LarsN05/InnovationsProjekt/ip-chassis-main/ip-motorshield/web-page.html

# IP Chassis Telemetry

Live telemetry and PID tuning over WiFi

Status: Disconnected

Connect

Start Moving Stop Moving

Connect to the ESP32 AP, then click Connect.

Encoder motor test

Target rpm: 0

Set Stop

Target: - rpm Measured: - rpm Ticks: -

PID and Settings

P I D Normal motor speed (0-4095)

advanced

Drive loop Hz Telemetry update Hz Enable deadzone compensation Min PWM to move Stop at checkpoints Brake when stopped Enable supply rails and M1/M2 current monitoring

Send Params Defaults

Live plot - Sensor error and Motor speeds (L / R)

No telemetry yet

Plot window (s) Save PNG

Sensor Error (left axis) Left Speed (right axis) Right Speed (right axis) Checkpoint

Telemetry (live)

QTR 0

QTR 1

QTR 2

QTR 3

QTR 4

Sensor Error

Left Speed

Right Speed

Battery V

P

I

D

Normal motor speed

Checkpoints

Last checkpoint ms

advanced telemetry

Servo rail V

M1 current A

M2 current A

Drive loop Hz (target)

Telemetry Hz (target)

Drive loop Hz (measured)

Drive loop exec us

Telemetry Hz (measured)

Telemetry exec us (peak)

Timestamp ms

Clear Console

Ready. Click Connect to start.
