LarsN05/InnovationsProjekt/ip-chassis-main/Hardware/Lasercut Files/A11_Motorshield-Stütze.pdf

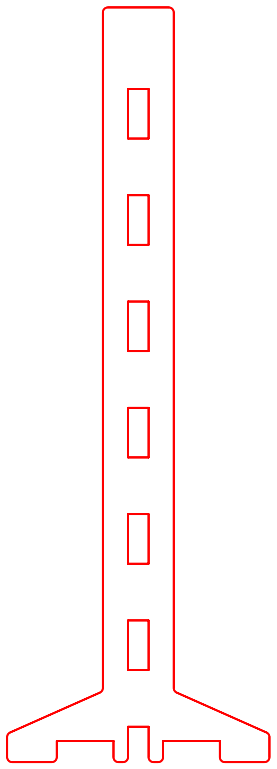
[picture p3: figure]
