LarsN05/InnovationsProjekt/ip-chassis-main/docs/BOM_MechatronikKit_IP26_20260826.pdf

### Innovationsprojekt 2026

# Mechatronik-Kit Inhalt

KOMPONENTEN

ESP32-S3 | https://www.waveshare.com/esp32-s3-dev-kit-n8r8.htm?sku=28836 Anzahl: 1 Hersteller: Waveshare Hersteller Art. Nr: ESP32-S3-DEV-KIT-N16R8-M

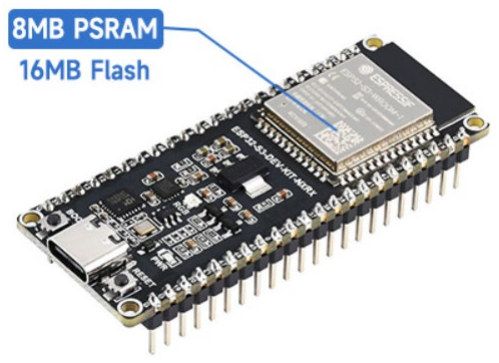
[picture p4: figure]

Motorshield ESP32-S3 - DRV8251A | Siehe GitLab-Repository • 6x DC-Motoren Steckplätze • 8x Servo Steckplätze • IOs + GND + 3.3V Header Anzahl: 1 Hersteller: Eigenbau ETH, pd|z

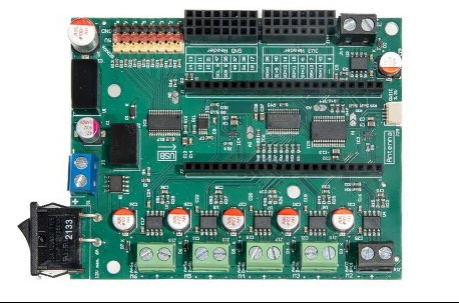
[picture p5: figure]

ESP32-S3 mit Motorshield gestacked

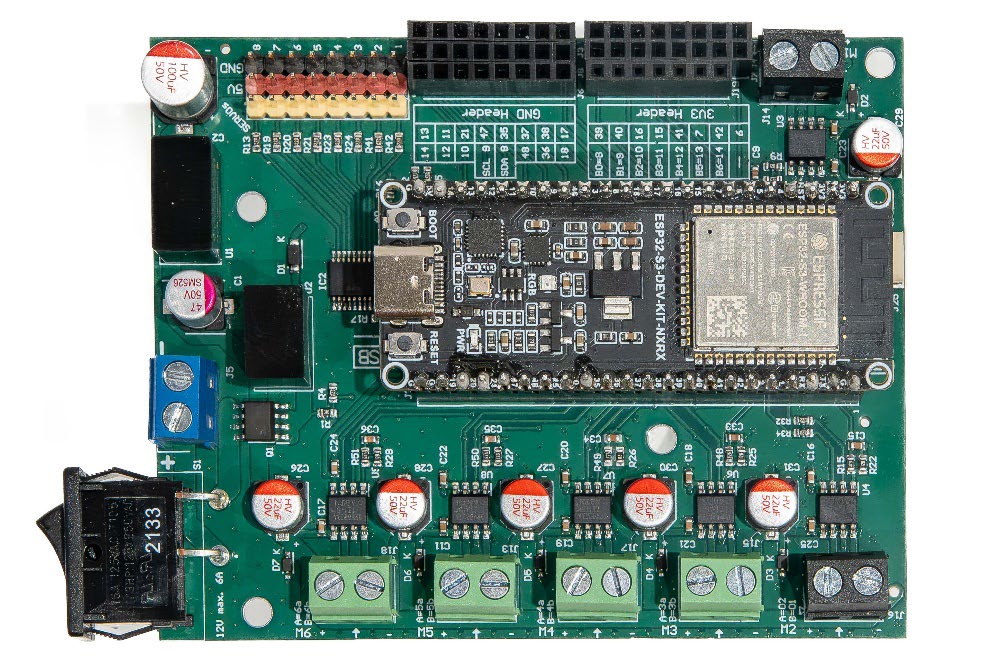
[picture p6: figure]

Jumper Kabel 20cm | https://www.mouser.ch/ProductDetail/Twin-Industries/TW-MF- 20C?qs=4qgZ1GHix0WzAEYYWLonEg%3D%3D (https://www.mouser.ch/ProductDetail/Twin-Industries/TW-MF-20C?qs=4qgZ1GHix0WzAEYYWLonEg%3D%3D)

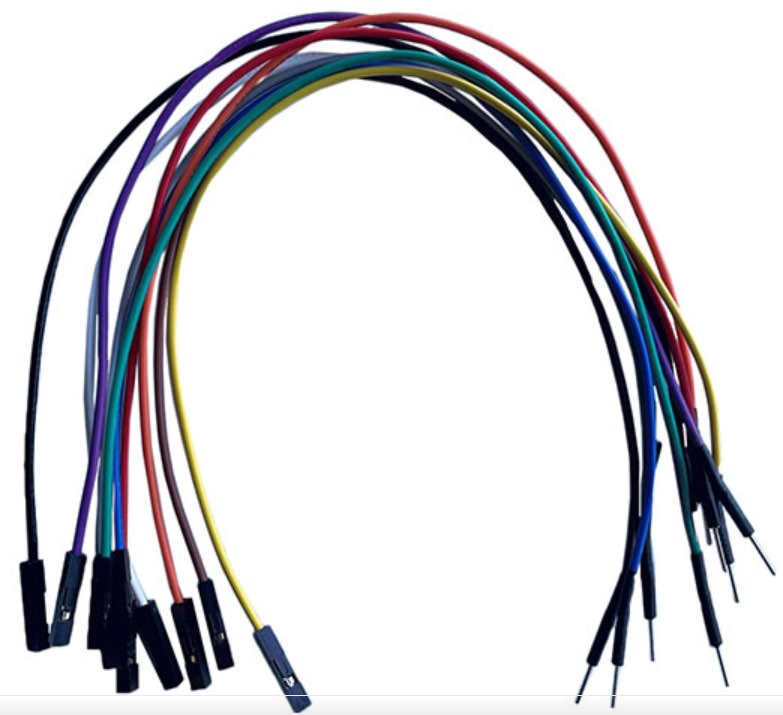
[picture p7: figure]

| Jumper-Kabel (Schaltdraht; Stecker - Buchse) 20cm, bunt
| Anzahl: 10 Käbelchen Hersteller: Twin Industries Hersteller Art. Nr: TW-MF-20C

Jumper Kabel 30cm | https://www.digikey.ch/en/products/detail/twin-industries/TW-MF-30C/14565017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 (https://www.digikey.ch/en/products/detail/twin-industries/TW-MF-30C/14565017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) Jumper-Kabel (Schaltdraht; Stecker - Buchse) 30cm, bunt Anzahl: 10 Käbelchen Hersteller: Twin Industries Hersteller Art. Nr: TW-MF-30C

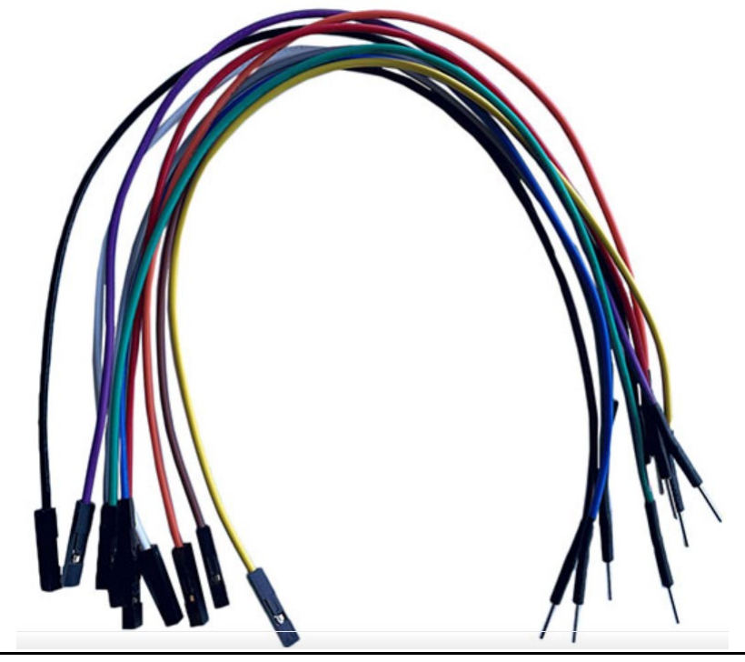
[picture p8: figure]

USB-C Kabel | https://www.conrad.ch/de/p/renkforce-usb-kabel-usb-c-stecker-usb-c-stecker-1-00-m-weiss-verdrillte-paare-rf-6056878-3028439.html (https://www.conrad.ch/de/p/renkforce-usb-kabel-usb-c-stecker-usb-c-stecker-1-00-m-weiss-verdrillte-paare-rf-6056878-3028439.html) Anzahl: 1 Hersteller: Renkforce Hersteller Art. Nr: RF-6056878

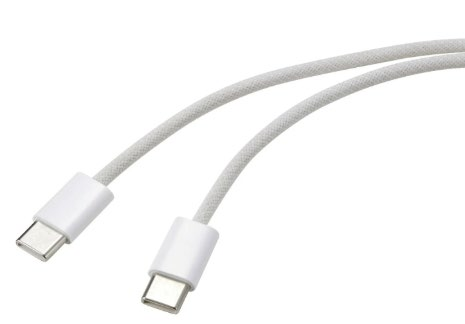
[picture p9: figure]

Servo S5252-030 | https://www.conrad.ch/de/p/reely-standard-servo-s-5252-030-digital-servo-getriebe-material-plastik-stecksystem-jr-2267525.html (https://www.conrad.ch/de/p/reely-standard-servo-s-5252-030-digital-servo-getriebe-material-plastik-stecksystem-jr-2267525.html) Anzahl: 2 Hersteller: Reely Typ: S5252-030 – 180 degrees

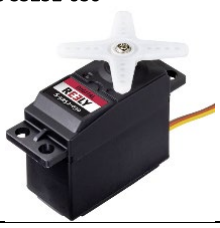
[picture p10: figure]

Servo TS90MD | https://de.aliexpress.com/item/1005009129632313.html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 v-specification (https://de.aliexpress.com/item/1005009129632313.html) Anzahl: 1 Hersteller: TIANKONGRC - AliExpress Typ: TS90MD - 270 degrees

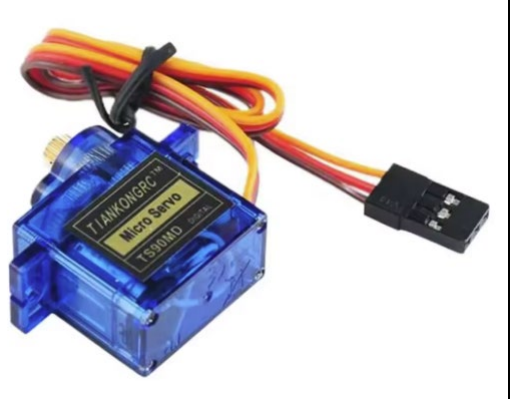
[picture p11: figure]
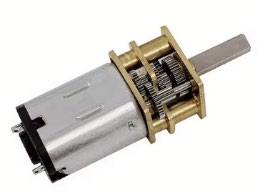
[picture p12: figure]

DC-Getriebemotor 60RPM | https://de.aliexpress.com/item/1005003431435613.html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 (https://de.aliexpress.com/item/1005003431435613.html?mp=1) Typ: 12V, 60RPM Hersteller: CNMAWAY Anzahl: 2

Doppelwellen Getriebemotor für Antrieb | https://de.aliexpress.com/item/1005006548341943.html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 (https://de.aliexpress.com/item/1005006548341943.html) Anzahl: 2 Hersteller: noname Typ: 3-12V
Reifen/Pneu für die Räder | https://www.brickowl.com/ch/catalog/lego-tire-37-x-22-zr-low-profile-55978 (https://www.brickowl.com/ch/catalog/lego-tire-37-x-22-zr-low-profile-55978) Anzahl: 2 Hersteller: Lego Hersteller Art. Nr. 55978 Typ: 37 x 22 zr low profile

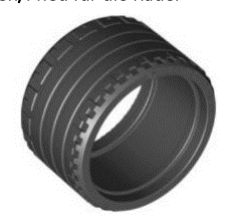
[picture p13: figure]

IR-Sensor | https://www.pololu.com/product/4145 Anzahl: 1 Hersteller: Pololu Typ: QTR-MD-05RC, 5-Channel Inkl. Befestigung (2x Kunststoffschraube M2, 25mm, 6x Sechskantmutter)

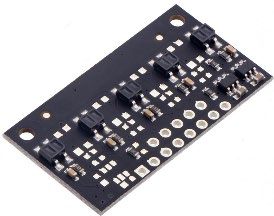
[picture p14: figure]

Drehrolle | https://www.pololu.com/product/953 Anzahl: 2 Hersteller: Pololu Hersteller Art. Nr.: 953

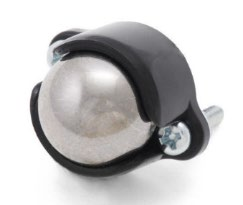
[picture p15: figure]

Akku | https://www.eremit.de/p/12v-2ah-flacher-lifepo4-mit-bms Anzahl: 1 Hersteller: EREMIT Typ: 12V 2Ah LiFePO4 mit JST-SM 2.54mm

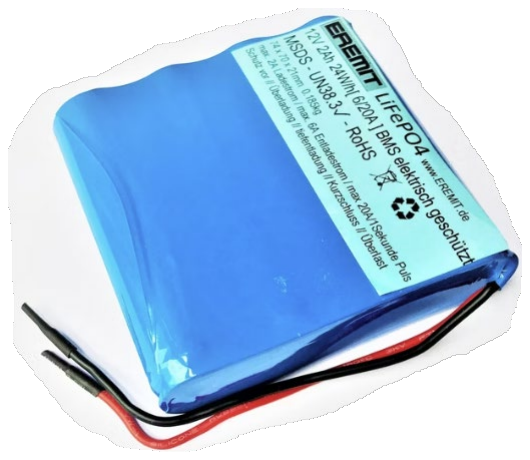
[picture p16: figure]

Ladegerät | https://www.eremit.de/p/12v-1a-lifepo4-ladegeraet Anzahl: 1 Hersteller: Eremit Typ: 12V 1A LiFePO4 Ladegerät mit JST-SM 2.54mm

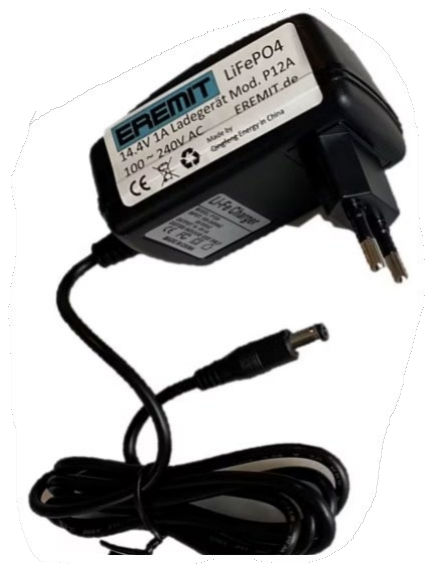
[picture p17: figure]

Kabelverbindung zwischen Motorshield & Akku | https://www.mouser.ch/ProductDetail/SparkFun/CAB-14574?qs=r5DSvlrkXmI%252B0h4Ae4w70g%3D%3D (https://www.mouser.ch/ProductDetail/SparkFun/CAB-14574?qs=r5DSvlrkXmI%252B0h4Ae4w70g%3D%3D) Anzahl: 1x Kabel mit Anschluss «male»

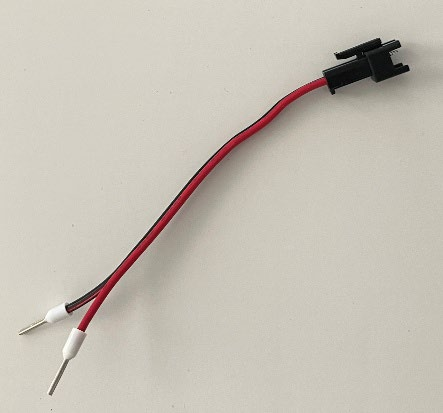
[picture p18: figure]
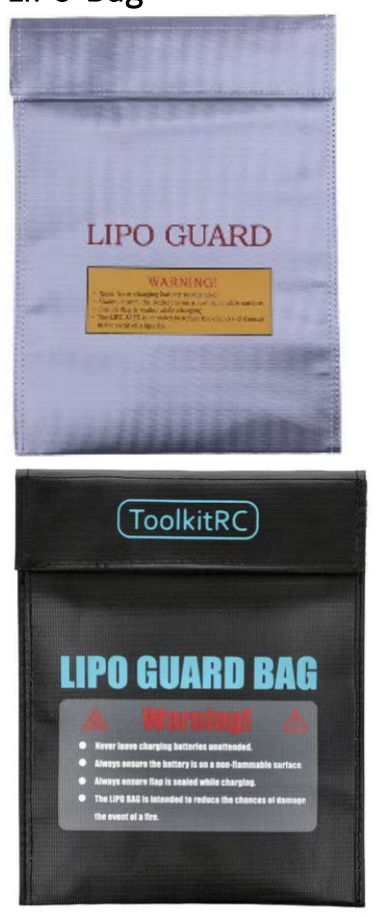
[picture p19: figure]

LiPo-Bag | https://www.brack.ch/g-t-power-lipo-tasche-large-981894https://www.brack.ch/toolkitrc-lipo-tasche-small-230-x-180-mm-1735426 (https://www.brack.ch/toolkitrc-lipo-tasche-small-230-x-180-mm-1735426) → Für Transport und Aufbewahrung Anzahl: 1 Hersteller: G.T. Power oder ToolkitRC Hersteller Art. Nr: 46 oder TK40600
