LarsN05/InnovationsProjekt/ip-chassis-main/docs/Stepfile_Motorshield_ESP32_V4_24082026.step

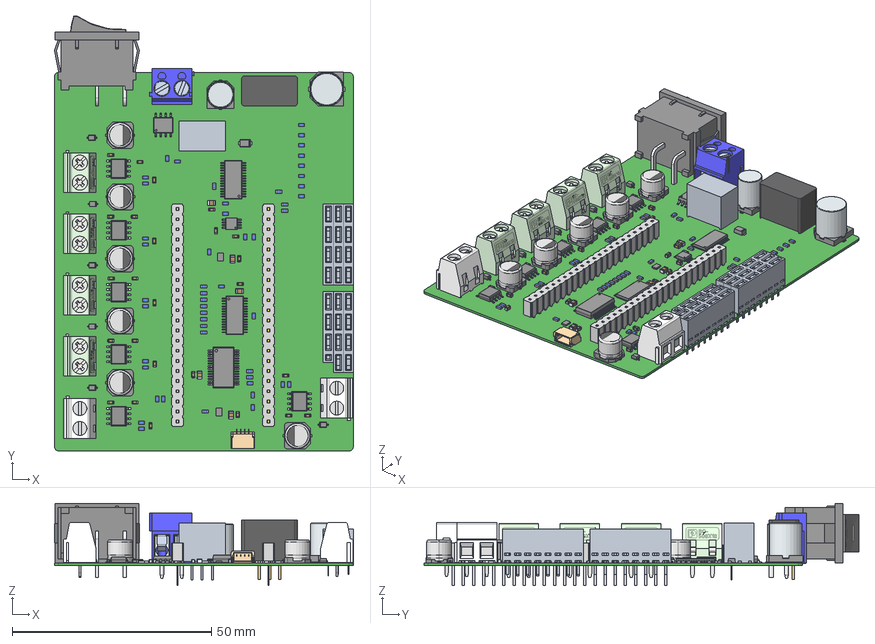
[picture p20: CAD file, 2026-09-24]
ip-chassis-main/docs/Stepfile_Motorshield_ESP32_V4_24082026.step
75.1 x 109.2 x 20.6 mm
FilletPinL x 6
FilletPinR x 6
PinsArrayLR x 5
KK_MKDSN_1_5_5_00 x 8
BC_508X10_SPP.1 x 8
AC_MKDSN_1_5_H1L x 8
BC_500X10_2_housing x 4
Insulator_2
Wire guard x 2
Screw x 2
Pin x 2
Pins x 2
PinKIdent
PinK
PinA
CES-122-01-S_socket x 2
012202SS x 2
012202SS2 x 2
BODY-SO x 6
LEAD-SO x 48
THERMALPAD-SO x 6
CASE-00
½¦-00
PIN-00 x 3
•W€SIZE CODE D-001_1 x 6
•W€SIZE CODE D-002_1 x 6
•W€SIZE CODE D-003_1 x 12
Base x 2
Pin1Fillet x 2
Pin2Fillet x 2
