LarsN05/InnovationsProjekt/ip-chassis-main/Hardware/STEP files/A11_Motorshield-Stütze.stp

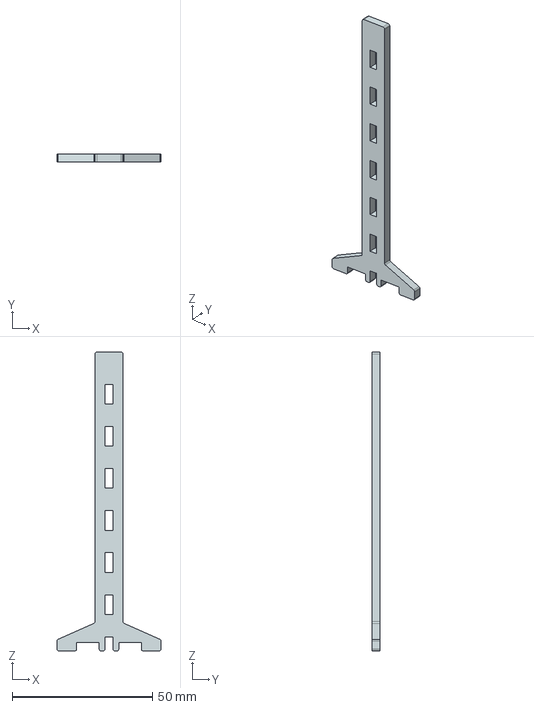
[picture p21: CAD file, 2026-09-24]
ip-chassis-main/Hardware/STEP files/A11_Motorshield-Stütze.stp
37.0 x 3.00 x 106.5 mm
