LarsN05/InnovationsProjekt/ip-chassis-main/Hardware/STEP files/A10_Sensor-Stütze.stp

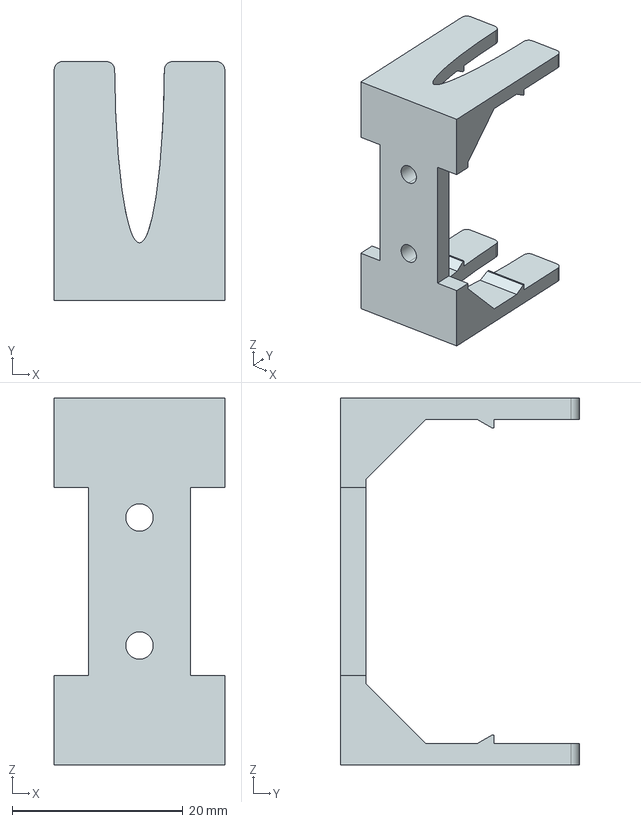
[picture p22: CAD file, 2026-09-24]
ip-chassis-main/Hardware/STEP files/A10_Sensor-Stütze.stp
20.0 x 28.0 x 43.0 mm
