LarsN05/InnovationsProjekt/ip-chassis-main/Hardware/STEP files/A04_Abstandshalter.stp

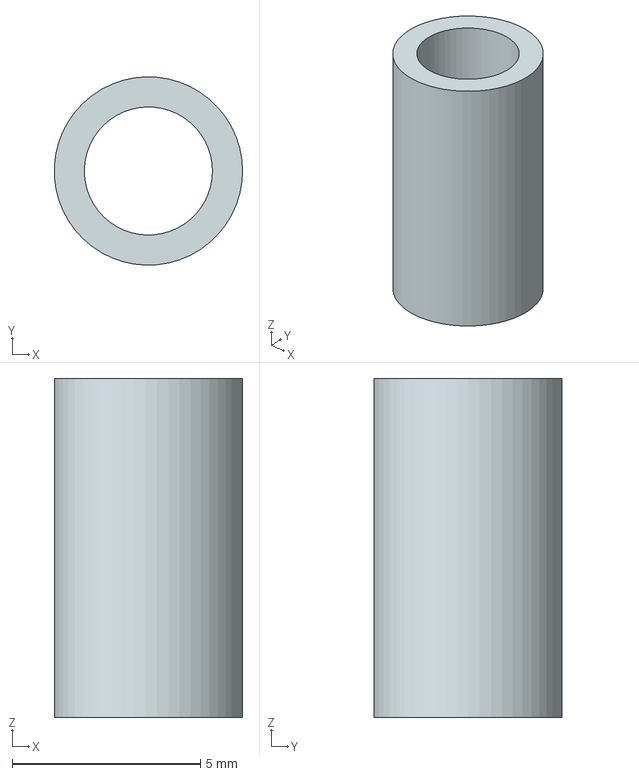
[picture p23: CAD file, 2026-09-24]
ip-chassis-main/Hardware/STEP files/A04_Abstandshalter.stp
5.00 x 5.00 x 9.00 mm
