LarsN05/InnovationsProjekt/ip-chassis-main/Hardware/STEP files/A12_Motorshield-Rahmen.stp

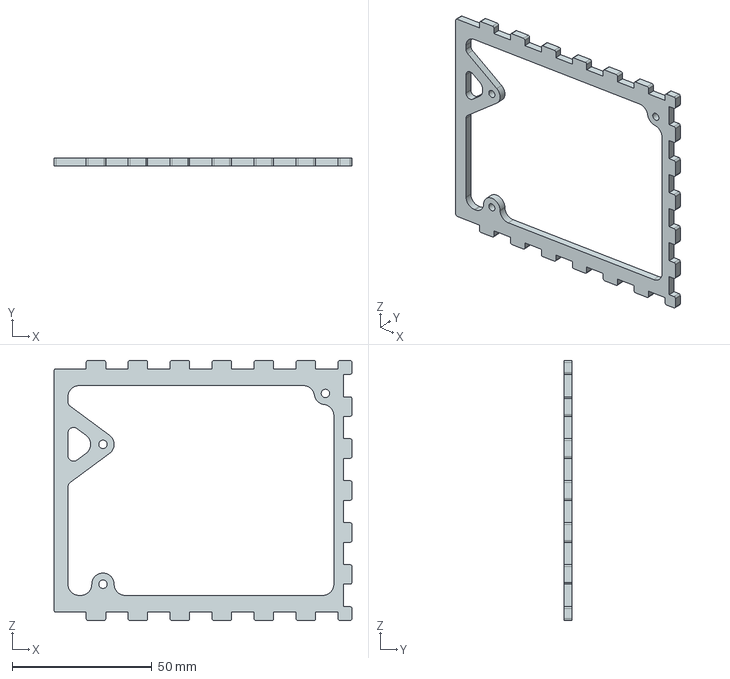
[picture p24: CAD file, 2026-09-24]
ip-chassis-main/Hardware/STEP files/A12_Motorshield-Rahmen.stp
106.5 x 3.00 x 93.0 mm
