LarsN05/InnovationsProjekt/ip-chassis-main/Hardware/STEP files/A06_Drehrollen-Halterung.stp

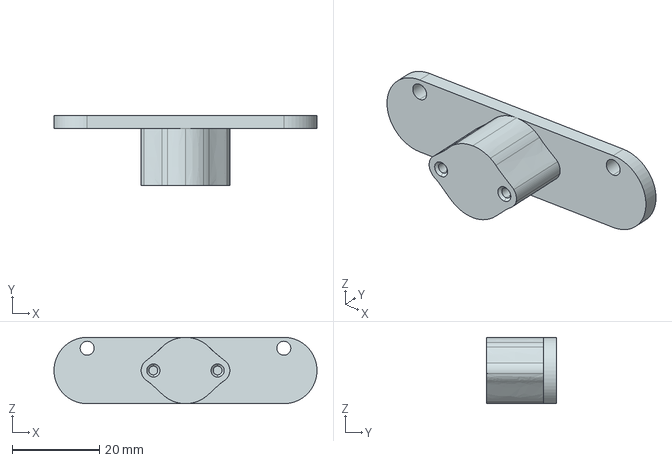
[picture p25: CAD file, 2026-09-24]
ip-chassis-main/Hardware/STEP files/A06_Drehrollen-Halterung.stp
60.2 x 16.0 x 15.2 mm
