LarsN05/InnovationsProjekt/ip-chassis-main/Hardware/STEP files/A05_Grundplatte.stp

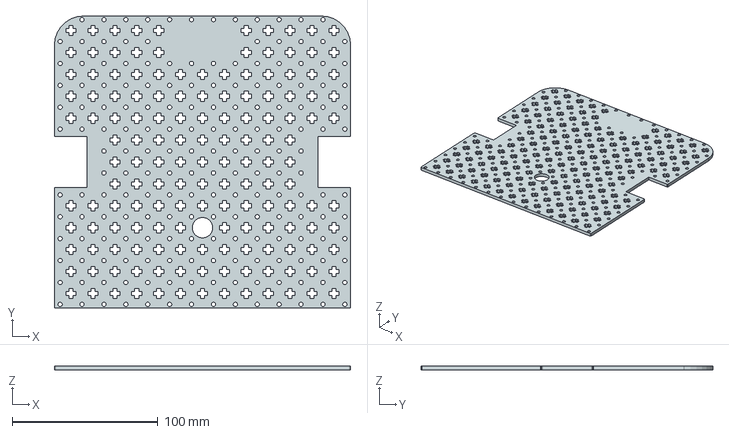
[picture p26: CAD file, 2026-09-24]
ip-chassis-main/Hardware/STEP files/A05_Grundplatte.stp
203.0 x 200.0 x 3.00 mm
