LarsN05/InnovationsProjekt/ip-chassis-main/Hardware/STEP files/A01_Batterie-Halterung.stp

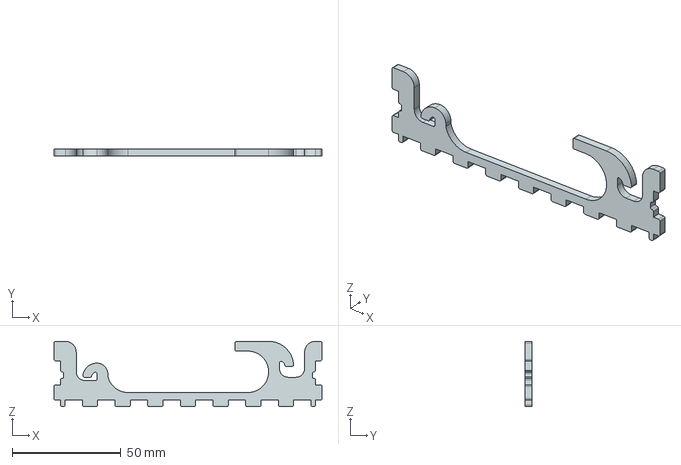
[picture p27: CAD file, 2026-09-24]
ip-chassis-main/Hardware/STEP files/A01_Batterie-Halterung.stp
123.0 x 3.00 x 30.0 mm
