LarsN05/InnovationsProjekt/ip-chassis-main/Hardware/STEP files/A09_Sensor-Rahmen.stp

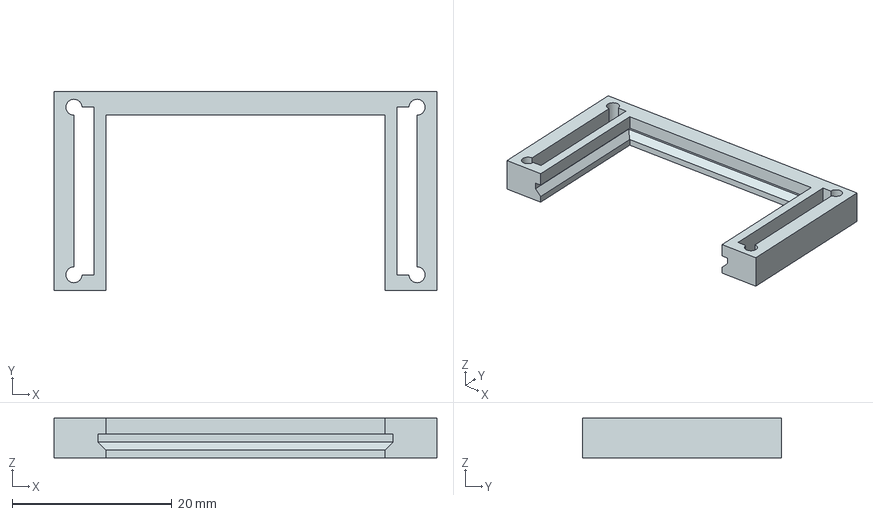
[picture p28: CAD file, 2026-09-24]
ip-chassis-main/Hardware/STEP files/A09_Sensor-Rahmen.stp
48.0 x 25.0 x 5.00 mm
