LarsN05/InnovationsProjekt/ip-chassis-main/docs/Schematic_Motorshield_ESP32_V4_25082026.PDF

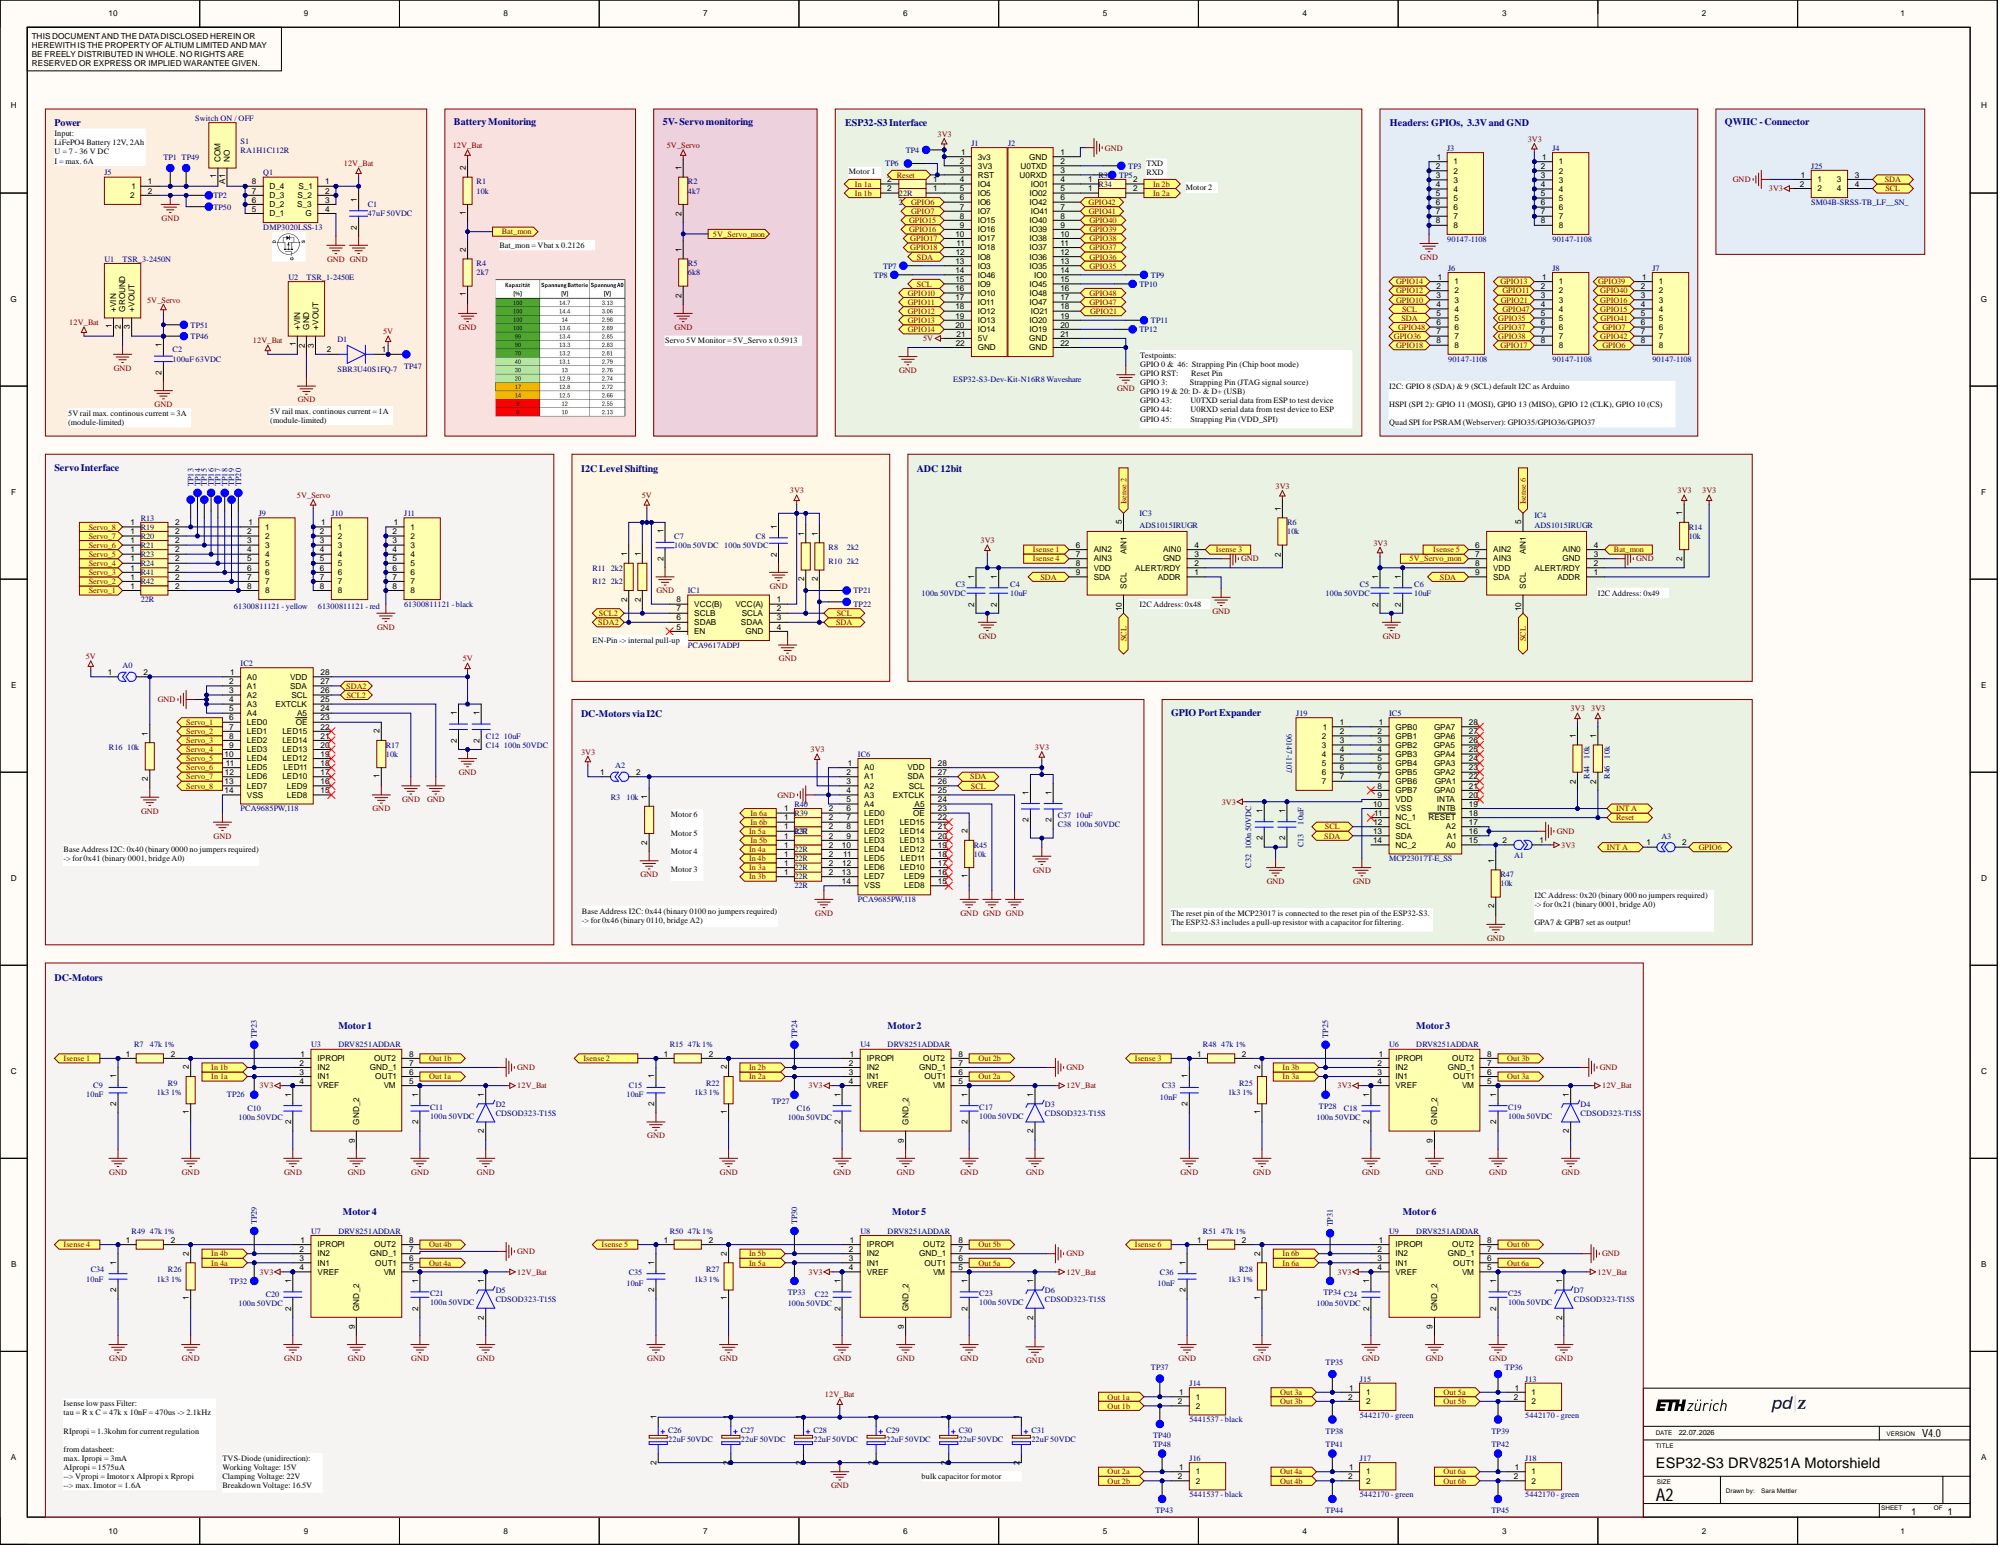
[picture p29: page 1]

THIS DOCUMENT AND THE DATA DISCLOSED HEREIN OR HEREWITH IS THE PROPERTY OF ALTIUM LIMITED AND MAY BE FREELY DISTRIBUTED IN WHOLE. NO RIGHTS ARE RESERVED OR EXPRESS OR IMPLIED WARANTEE GIVEN.

Headers: GPIOs, 3.3V and GND

Testpoints:
GPIO 0 & 46: Strapping Pin (Chip boot mode)
GPIO 19 & 20: D- & D+ (USB)

I2C: GPIO 8 (SDA) & 9 (SCL) default I2C as Arduino

5V rail max. continous current = 1A
(module-limited)

HSPI (SPI 2): GPIO 11 (MOSI), GPIO 13 (MISO), GPIO 12 (CLK), GPIO 10 (CS)

5V rail max. continous current = 3A

Quad SPI for PSRAM (Webserver): GPIO35/GPIO36/GPIO37

EN-Pin -> internal pull-up

Base Address I2C: 0x40 (binary 0000 no jumpersrequired)
-> for 0x41 (binary 0001, bridge A0)

I2C Address: 0x20 (binary 000 no jumpersrequired)
-> for 0x21 (binary 0001, bridge A0)

Base Address I2C: 0x44 (binary 0100 no jumpersrequired)
-> for 0x46 (binary 0110, bridge A2)

The reset pin of the MCP23017 is connected to the reset pin of the ESP32-S3.
The ESP32-S3 includes a pull-up resistor with a capacitor for filtering.

Isense low pass Filter:
tau = R x C = 47k x 10nF = 470us -> 2.1kHz

RIpropi = 1.3kohm for current regulation

from datasheet:
max. Ipropi = 3mA
AIpropi = 1575uA
--> Vpropi = Imotor x AIpropi x Rpropi
--> max. Imotor = 1.6A

bulk capacitor for motor

SIZE A2 | Drawn by: Sara Mettler

SHEET OF 1 1
