LarsN05/InnovationsProjekt/ip-chassis-main/Hardware/Technical Drawings/C02_Felgen_Technische-Zeichnung.pdf

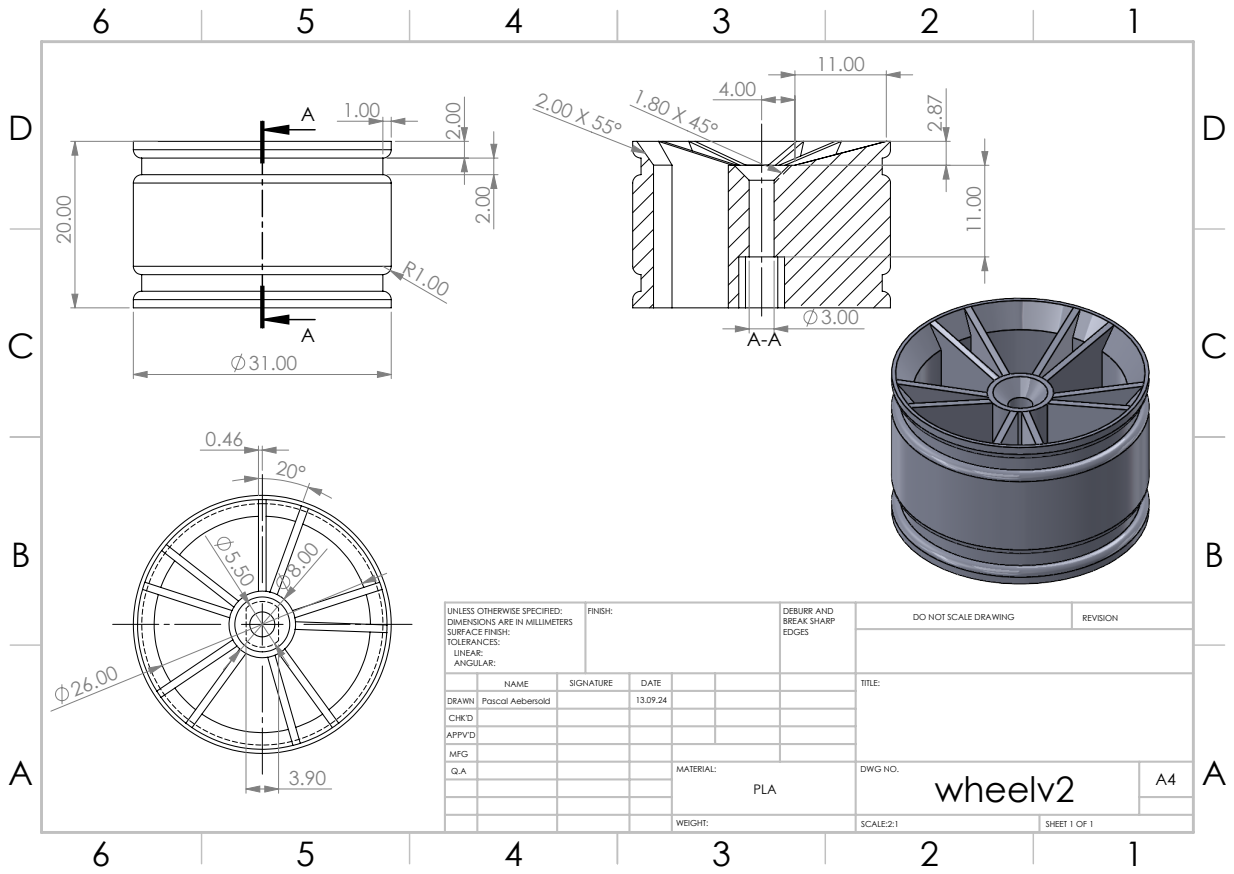
[picture p30: page 1]
FINISH:; DEBURR AND; BREAK SHARP; DO NOT SCALE DRAWING; REVISION; SCALE:2:1; SHEET 1 OF 1

UNLESS OTHERWISE SPECIFIED:
DIMENSIONS ARE IN MILLIMETERS
SURFACE FINISH:
TOLERANCES:
LINEAR:
ANGULAR:

NAME | SIGNATURE | DATE | | | | TITLE:

DRAWN | Pascal Aebersold | | 13.09.24
CHK'D
APPV'D
MFG
Q.A | | | | MATERIAL: PLA | DWG NO. wheelv2 | A4
