LarsN05/InnovationsProjekt/ip-chassis-main/docs/Assembly_BottomTop_Motorshield_ESP32_V4_25082026.PDF

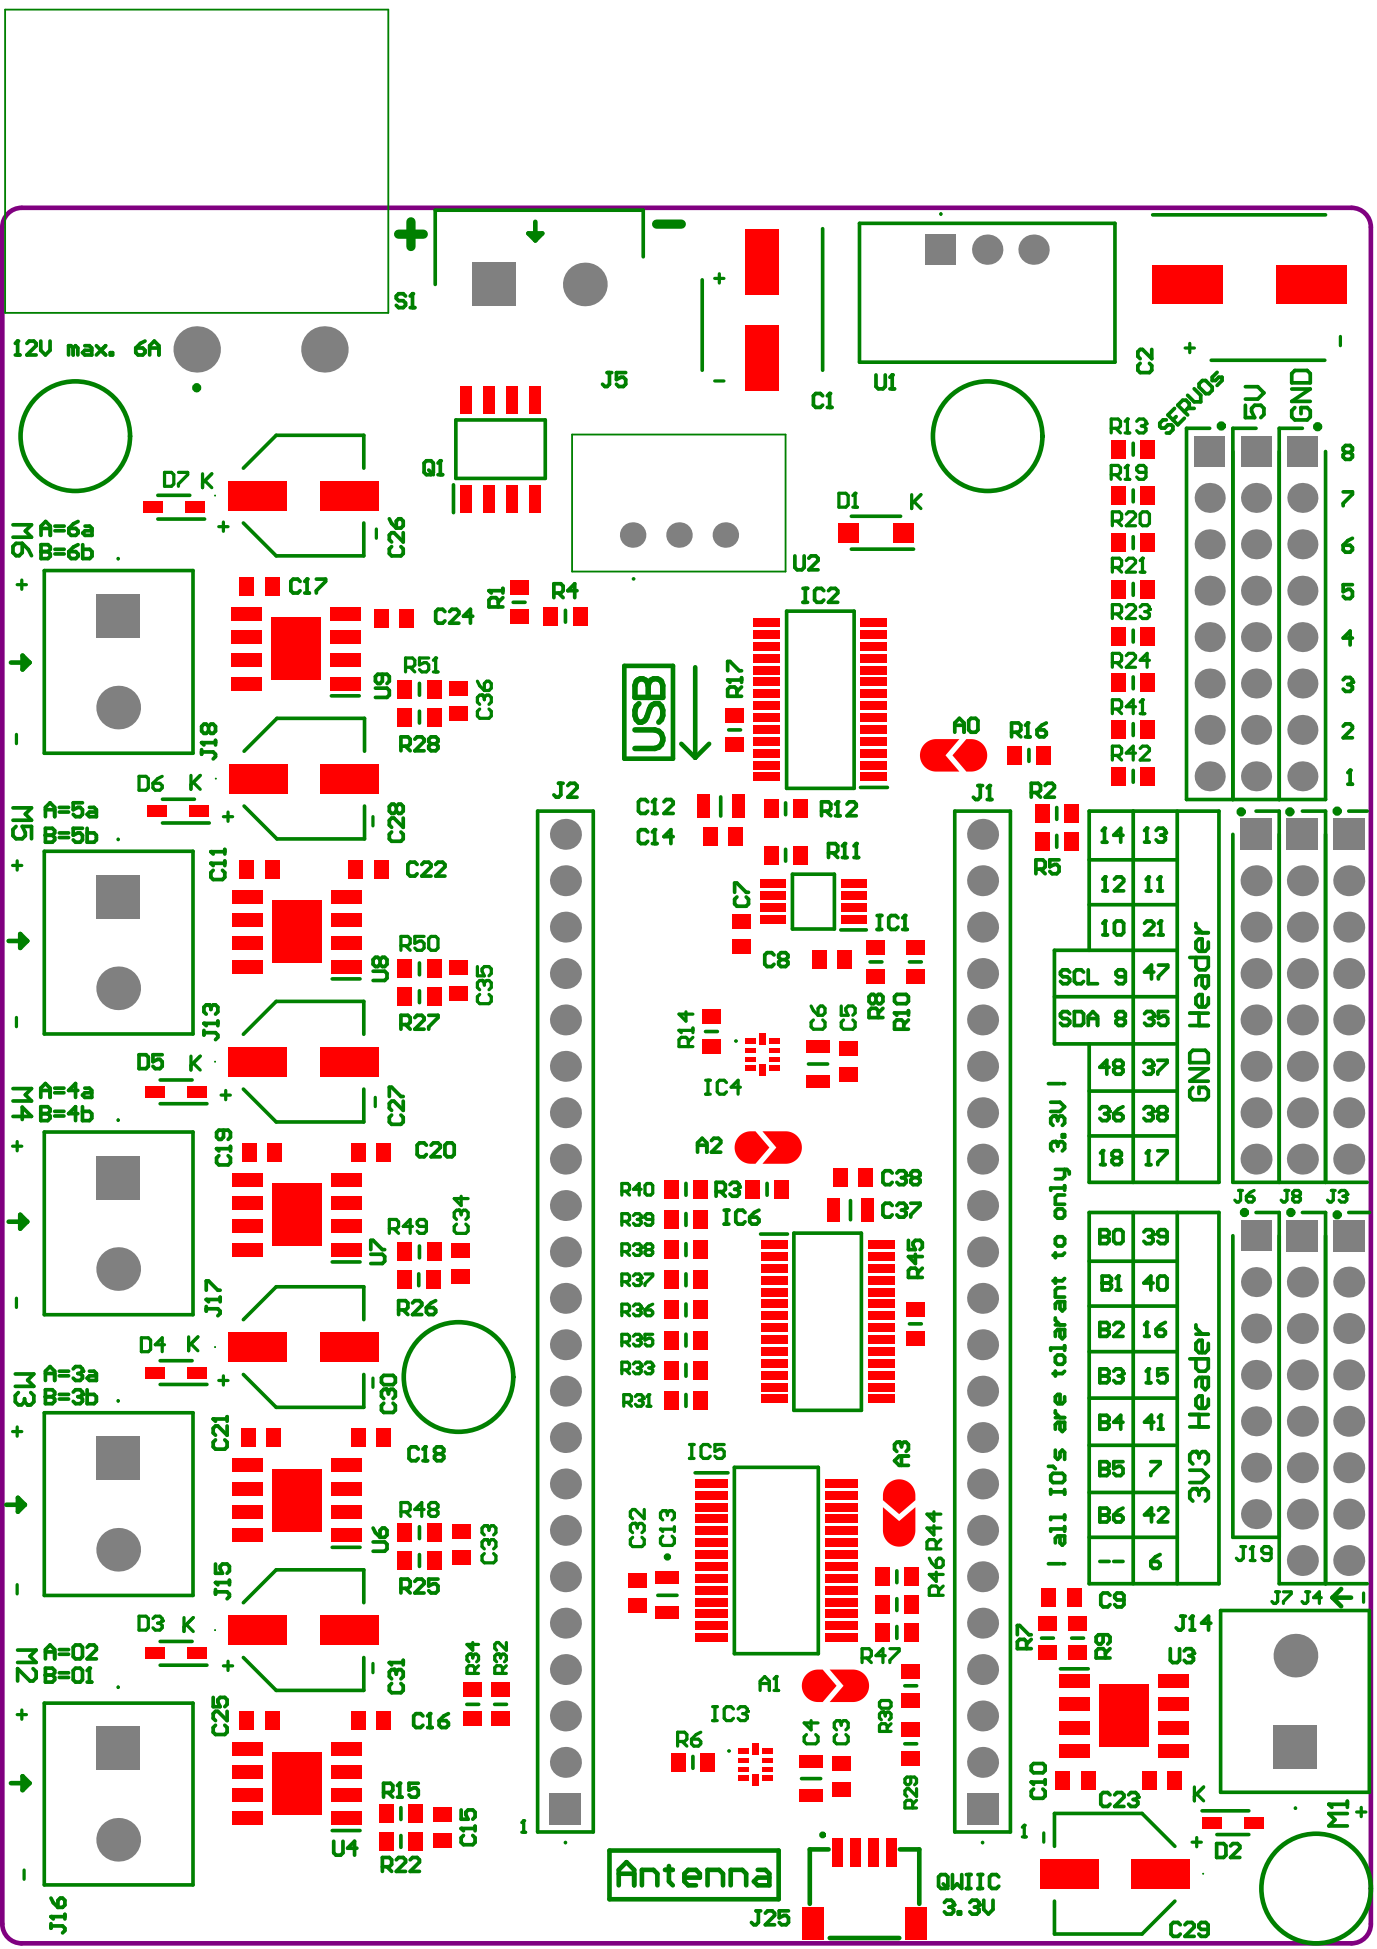
[picture p31: page 1]

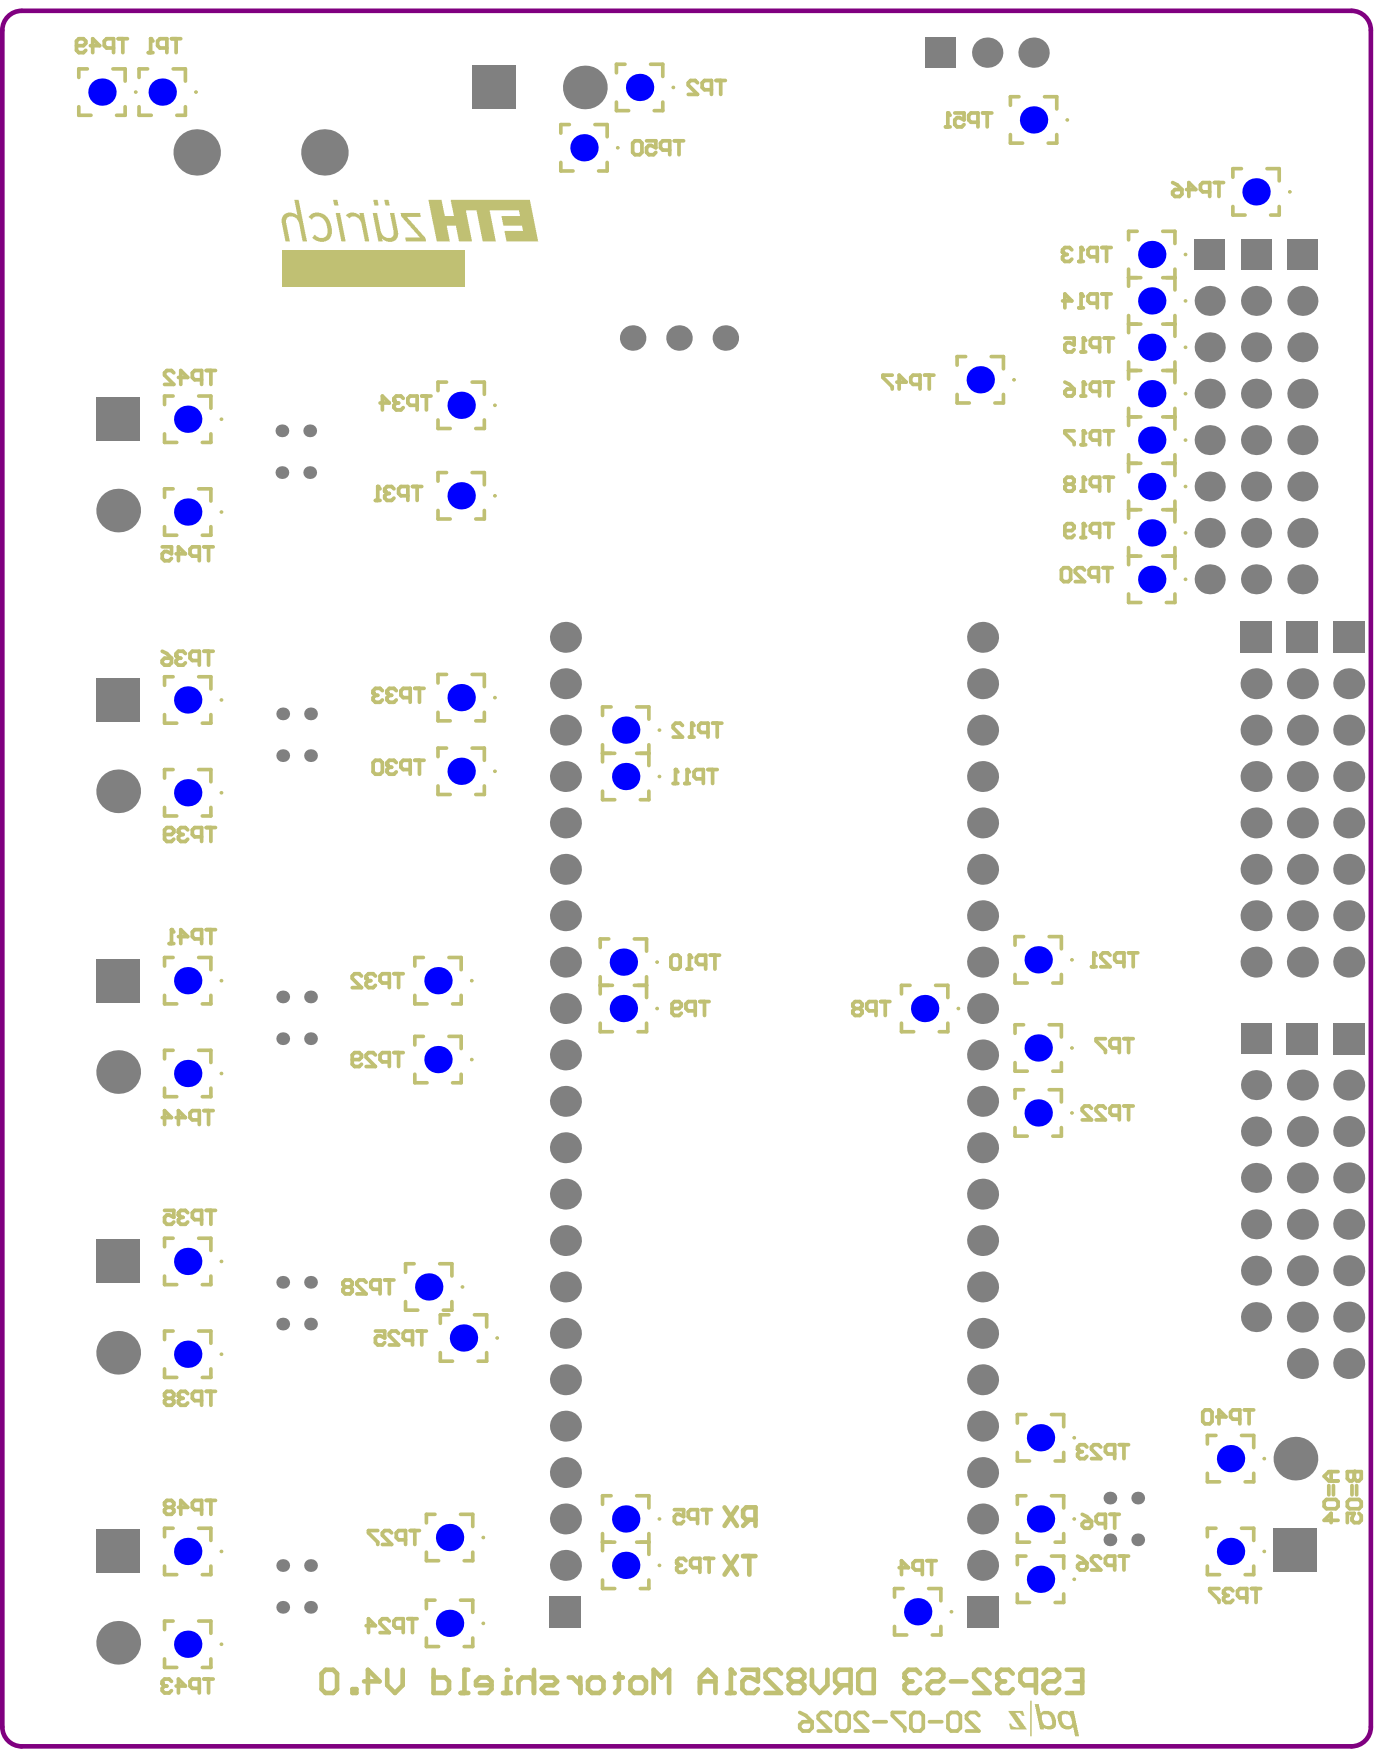
[picture p32: page 2]
