LarsN05/InnovationsProjekt/ip-chassis-main/Hardware/Lasercut Files/A01_Batterie-Halterung.pdf

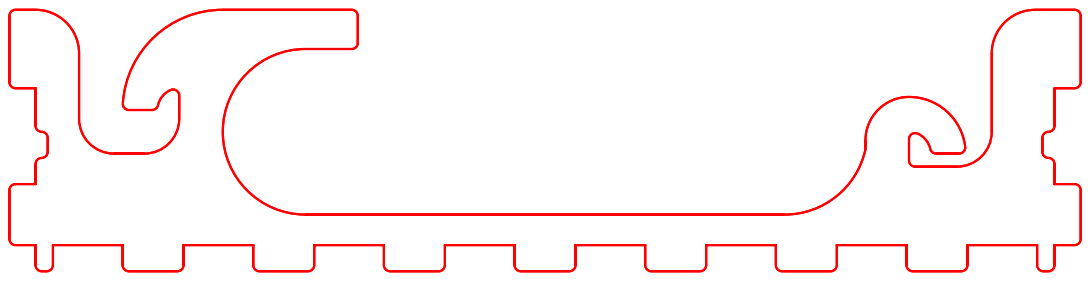
[picture p33: page 1]
