LarsN05/InnovationsProjekt/ip-chassis-main/Hardware/Lasercut Files/A05_Grundplatte.pdf

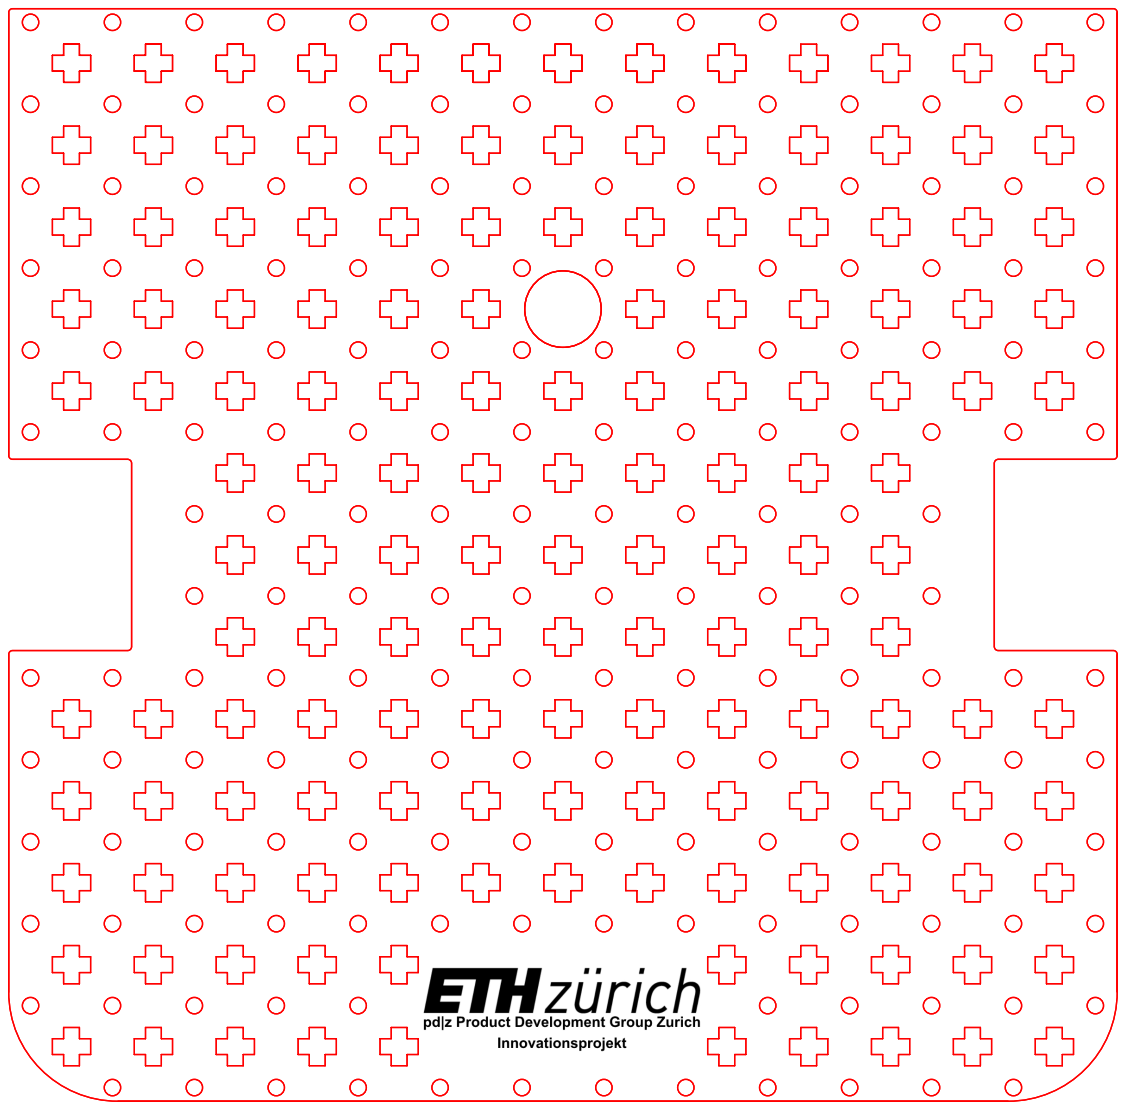
[picture p34: page 1]
