LarsN05/InnovationsProjekt/ip-chassis-main/Hardware/Lasercut Files/A12_Motorshield-Rahmen.pdf

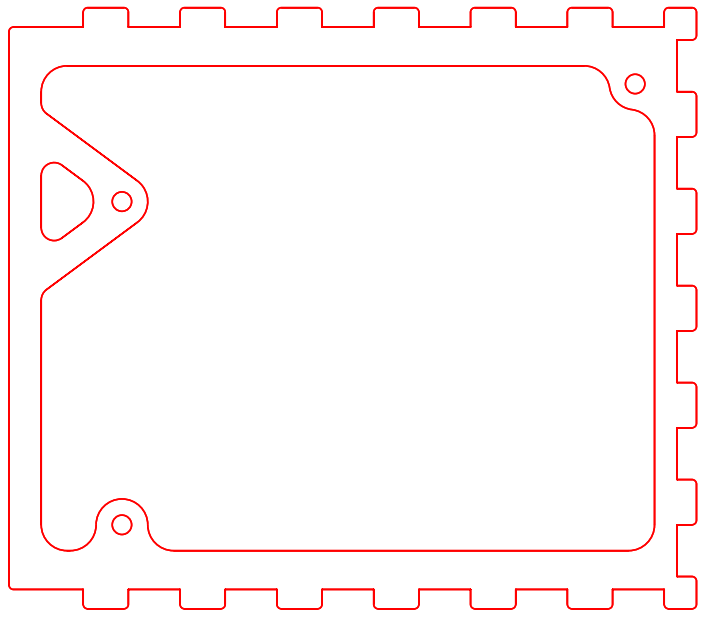
[picture p35: page 1]
