LarsN05/InnovationsProjekt/ip-chassis-main/Hardware/Technical Drawings/A05_Grundplatte_Technische-Zeichnung.pdf

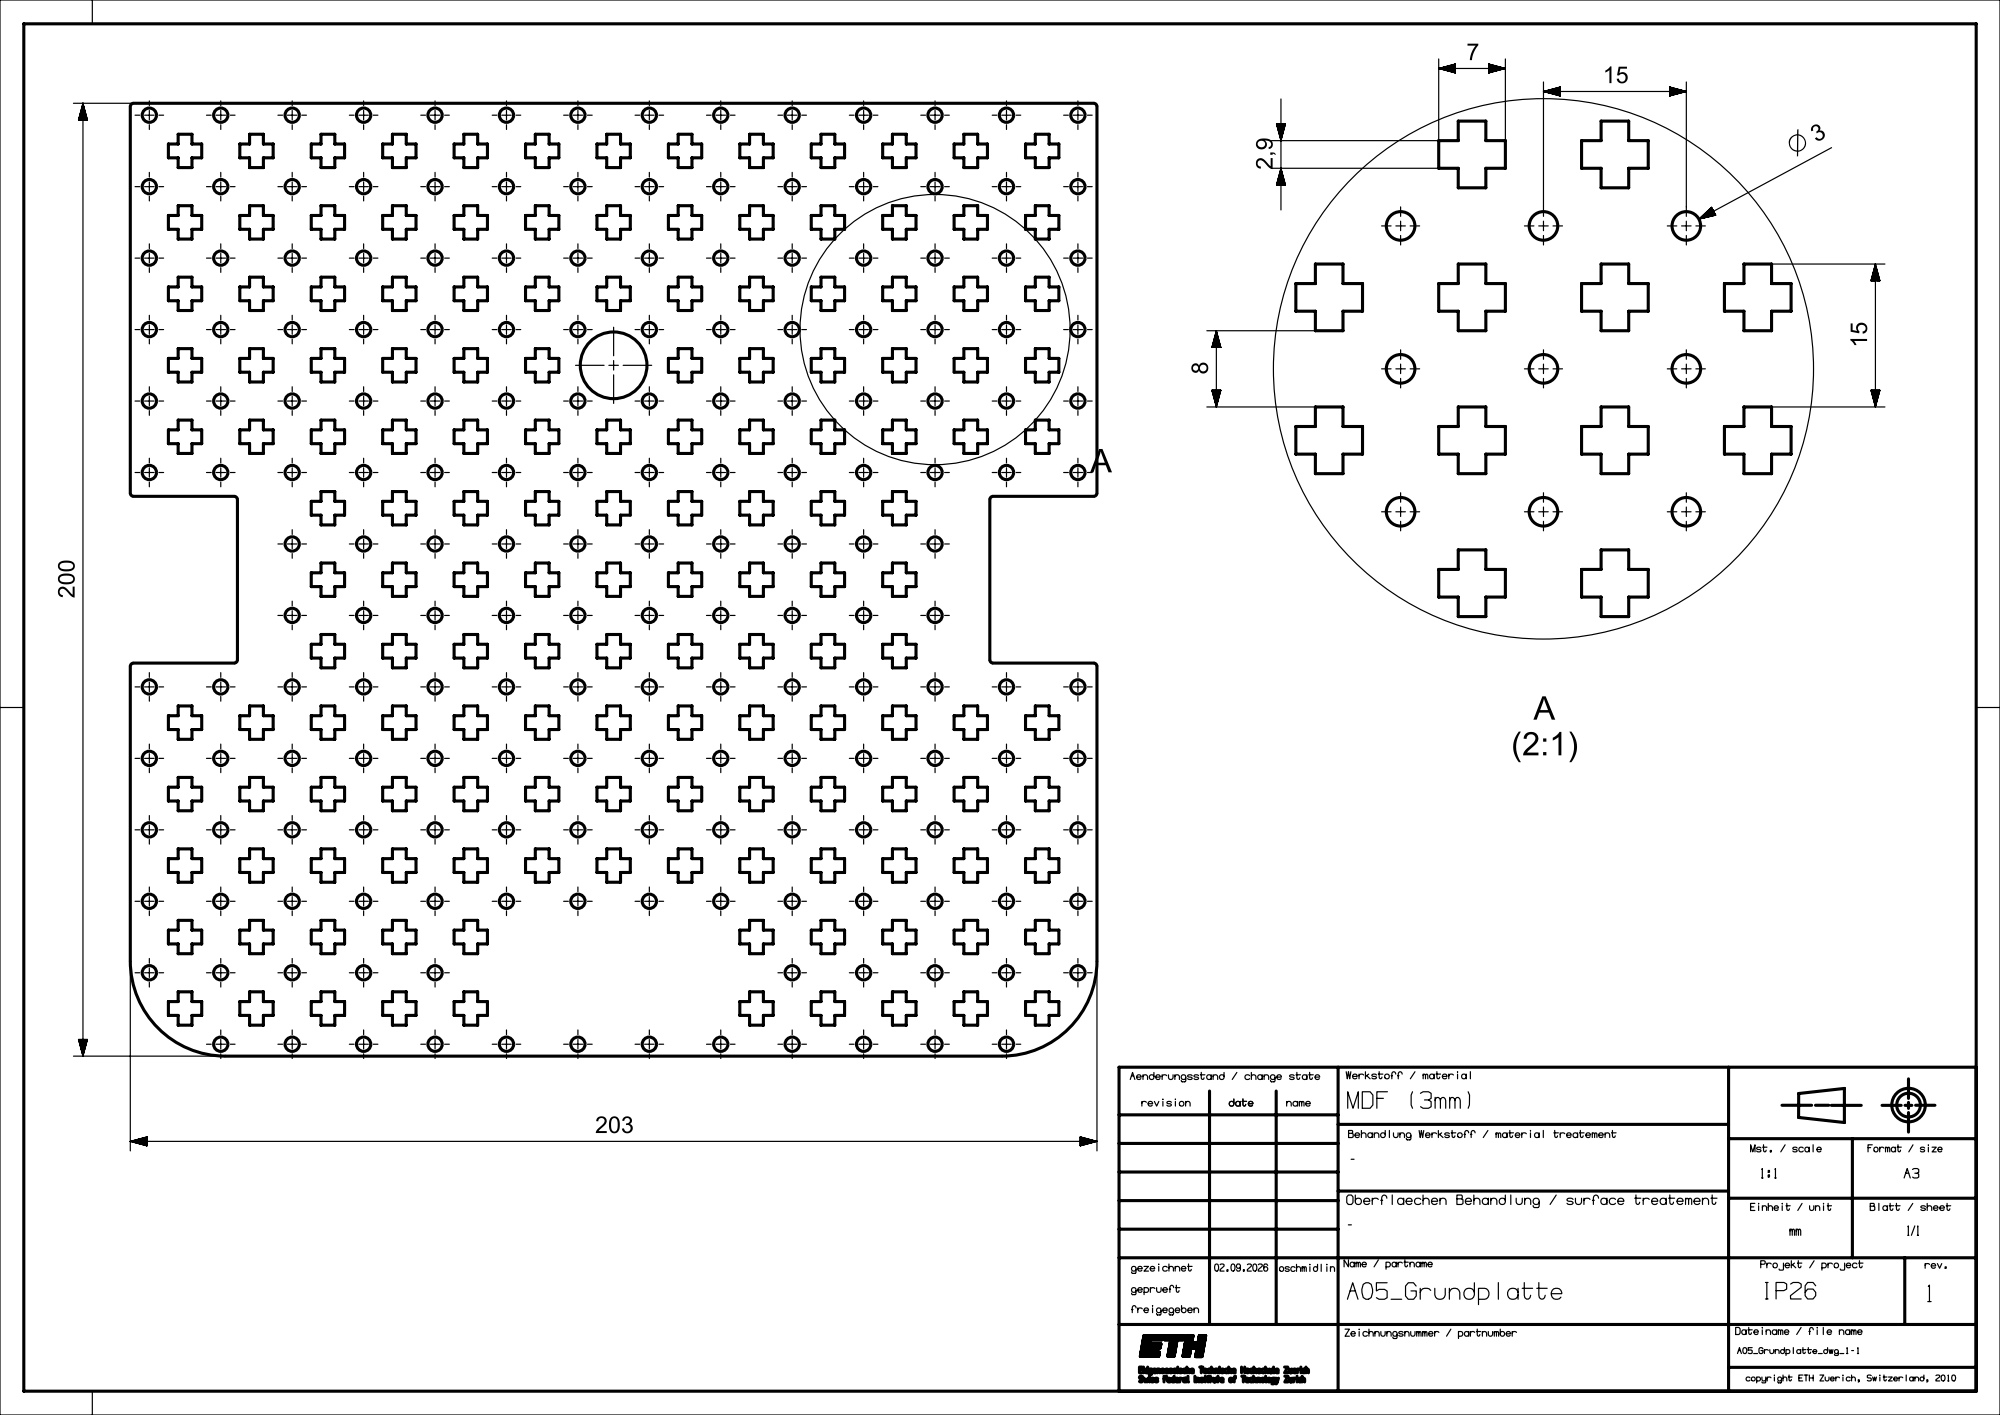
[picture p36: page 1]
