LarsN05/InnovationsProjekt/ip-chassis-main/Hardware/Technical Drawings/C01_Motoren-Halterung_Technische-Zeichnung.pdf

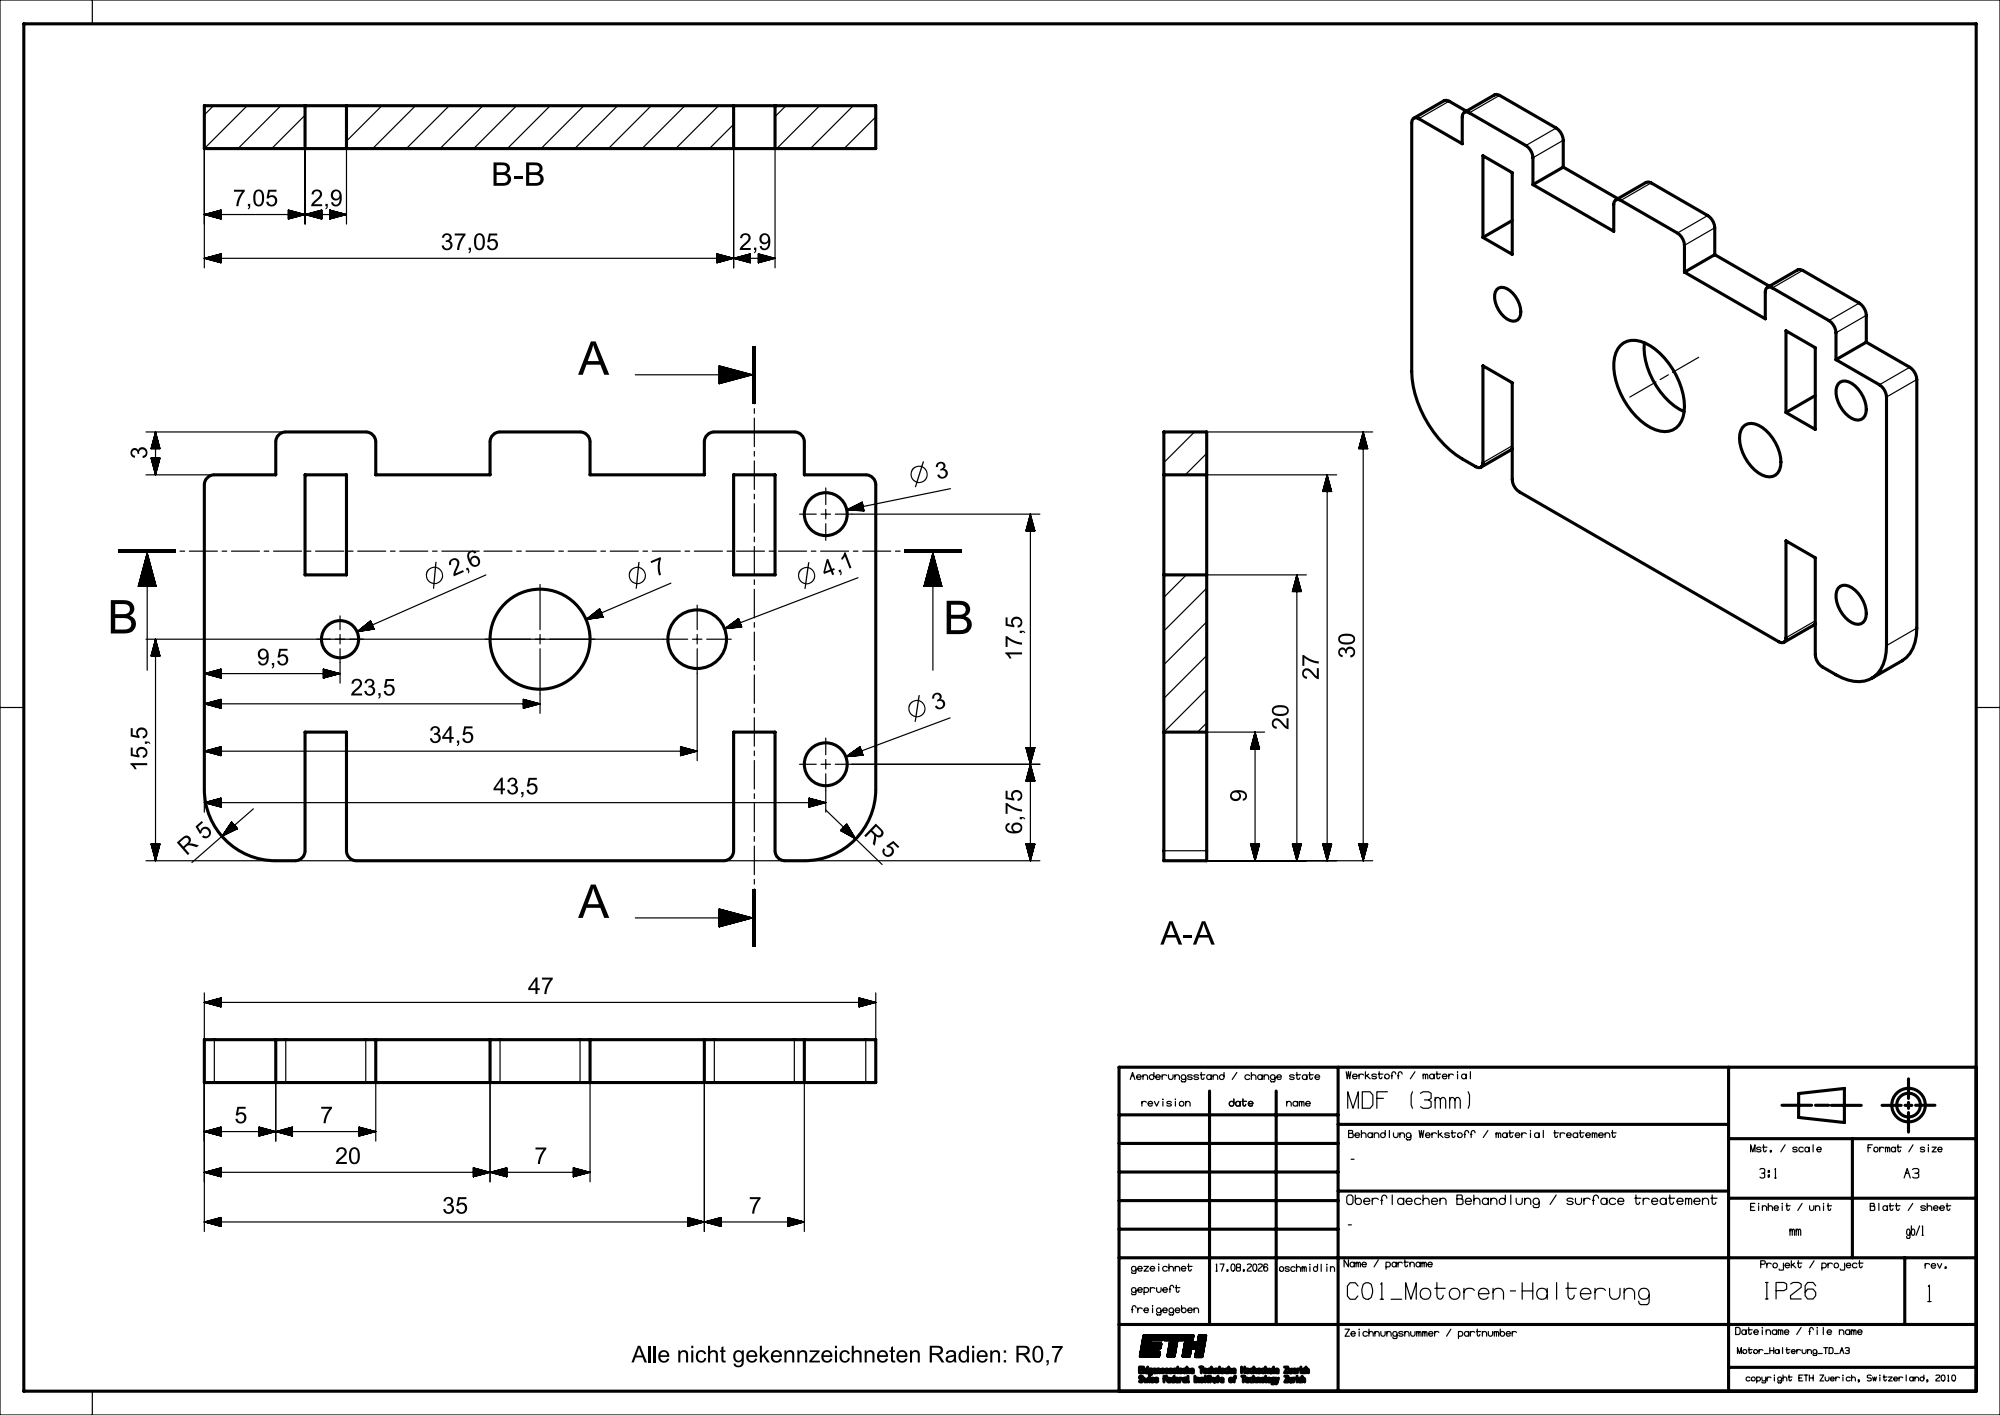
[picture p37: page 1]
