LarsN05/InnovationsProjekt/ip-chassis-main/ip-motorshield/line-follower.cpp

#include "line-follower.h"
#include "config.h"
#include "shared-globals.h"
#include <Arduino.h>
#include "movement-functions.h"
#include "src/motorshield/motorshield.h"

extern Motorshield shield;

float calculatePIDstep(PIDController &pid, float measurement, float executionFrequency)
{
    pidError = (int)(pid.target - measurement);

    // integral windup prevention
    const float maximumOutput = PWM_MAX_VALUE;
    float integralLimit = maximumOutput / pid.ki;
    float dt = 1.0f / executionFrequency; // normally 40 Hz, so dt = 0.025s
    pid.integral += pidError * dt;
    pid.integral = constrain(pid.integral, -integralLimit, integralLimit);

    // integral reset to prevent overshooting after long build-up when approaching the line from far away
    bool isCrossingLine = (pidError > 0) != (pid.prevError > 0);
    if (isCrossingLine)
    {
        pid.integral = 0;
    }

    // Derivative term (indiferent if based on pidError or measurement, since target is constant (=0))
    // (pidError - previousError) / dt;
    // == (-measurement - (-prevMeasurement)) / dt;  if target is constant
    // == -(measurement - prevMeasurement) / dt;
    float derivative = (pidError - pid.prevError) / dt;

    float control = pid.kp * pidError + pid.ki * pid.integral + pid.kd * derivative;

    pid.prevError = pidError;

    return control;
}

void updateLineStatus()
{
    for (uint8_t i = 0; i < QTR_SENSOR_COUNT; i++)
    {
        if (qtrSensorValues[i] > BLACKLINE_THRESHOLD)
        {
            qtrSensorStatus[i] = 1;
        }
        else
        {
            qtrSensorStatus[i] = 0;
        }
    }

    if (qtrSensorStatus[0] == 1 && qtrSensorStatus[4] == 1 && (qtrSensorStatus[1] == 0 || qtrSensorStatus[2] == 0 || qtrSensorStatus[3] == 0))
    {
        lineStatus = STATION;
    }
    else if (qtrSensorStatus[0] == 1 && qtrSensorStatus[1] == 1 && qtrSensorStatus[2] == 1 && qtrSensorStatus[3] == 1 && qtrSensorStatus[4] == 1)
    {
        lineStatus = STOP;
    }
    else
    {
        lineStatus = NORMAL;
    }
}

/*
 *  @summary overcome static friction in low speed range
 */
static int compensateDeadzoneWithFlip(int speedCommand)
{
    if (speedCommand == 0)
    {
        return 0;
    }

    int sign = (speedCommand > 0) ? 1 : -1;
    int magnitude = abs(speedCommand);

    if (magnitude >= minPWMtoMoveMotor)
    {
        // Keep direction; ensure we overcome stiction
        int pwm = magnitude; // already ≥ MIN
        if (pwm > PWM_MAX_VALUE)
        {
            pwm = PWM_MAX_VALUE;
        }
        return sign * pwm;
    }
    else
    {
        // Flip direction and push magnitude above MIN
        int flippedMag = 2 * minPWMtoMoveMotor - magnitude; // e.g., magnitude=44, MIN=45 -> -46
        if (flippedMag > PWM_MAX_VALUE)
        {
            flippedMag = PWM_MAX_VALUE;
        }
        return -sign * flippedMag;
    }
}

void setMotorSpeeds(int signal, Motor &motorL, Motor &motorR)
{
    leftMotorSpeed = constrain(defaultMotorSpeed + signal, -PWM_MAX_VALUE, PWM_MAX_VALUE);
    rightMotorSpeed = constrain(defaultMotorSpeed - signal, -PWM_MAX_VALUE, PWM_MAX_VALUE);

    if (enableMotorDeadzoneCompensation)
    {
        leftMotorSpeed = compensateDeadzoneWithFlip(leftMotorSpeed);
        rightMotorSpeed = compensateDeadzoneWithFlip(rightMotorSpeed);
    }

    motorL.setSpeed(leftMotorSpeed);
    motorR.setSpeed(rightMotorSpeed);
}

void drivingLoop(PIDController &pid, QTRSensors &qtr, Motor &motorL, Motor &motorR)
{
    int position = qtr.readLineBlack(qtrSensorValues);
    updateLineStatus();

    if (!robotMotionEnabled)
    {
        controlSignal = 0.0f;
        leftMotorSpeed = 0;
        rightMotorSpeed = 0;
        if (brakeWhenStopped)
        {
            motorL.brake();
            motorR.brake();
        }
        else
        {
            motorL.stop();
            motorR.stop();
        }
        oldLineStatus = lineStatus;
        return;
    }

    controlSignal = calculatePIDstep(pid, position, driveLoopHzTarget);
    setMotorSpeeds(controlSignal, motorL, motorR);

    if (lineStatus != oldLineStatus)
    {
        switch (lineStatus)
        {
            // TODO for students: Implement your own cases needed to complete the required tasks your roboter has to complete during the run
        case STOP:
            checkpointCounter++;
            lastCheckpointTimeMs = millis();

            if (stopAtCheckpoints)
            {
                motorL.brake();
                motorR.brake();
                delay(1000);
            }

            if(checkpointCounter == distributionCenter){
                motorL.brake();
                motorR.brake();
                //servo ansteuern
                motorL.setSpeed(-800);
                motorR.setSpeed(-800);
                delay(500);
                motorL.brake();
                motorR.brake();
                shield.servo(1).setAngleRange(270);
                shield.servo(1).setAngle(0);
                delay(500);
                motorL.setSpeed(800);
                motorR.setSpeed(800);
                delay(900);
                motorL.brake();
                motorR.brake();
                delay(500);
                motorL.setSpeed(-800);
                motorR.setSpeed(-800);
                delay(600);
                motorL.brake();
                motorR.brake();
                shield.servo(1).setAngle(150);
                delay(1000);
                
            }

            if(checkpointCounter == turnCheckpoint+1){
                motorL.brake();
                motorR.brake();
                delay(200);
                if(!perform180Turn(qtr, motorL, motorR)){
                    robotMotionEnabled = false;
                    blinkWarningPattern(255, 0, 0, 10);
                }
                //resetting the line following errors to ensure a clean start after the turn
                pid.integral = 0;
                pid.prevError = 0;
                delay(200);

            
                /*motorL.setSpeed(800);
                motorR.setSpeed(800);
                delay(1000);
                motorL.brake();
                motorR.brake();*/
                shootSequence(false, 150);
                shootSequence(false, 130);
                shootSequence(false, 100);
            
            }

            if(checkpointCounter == finalCheckpoint){
                allignOnCheckpoint(pid, qtr, motorL, motorR);
                motorL.brake();
                motorR.brake();
                robotMotionEnabled = false;
                
            }



            if(checkpointCounter == 4){
                motorL.brake();
                motorR.brake();
                for(int i = 0; i <= 10; i++){
                    turnUntilPackage();
                    delay(300);
                }
                robotMotionEnabled = false;
                /*motorL.brake();
                motorR.brake();
                motorL.setSpeed(800);
                motorR.setSpeed(800);
                delay(1000);
                motorL.brake();
                motorR.brake();
                shootSequence(false, 90);
                shootSequence(false, 60);
                shootSequence(false, 110);
                */
            }

            if(checkpointCounter == 5){
                motorL.brake();
                motorR.brake();
                /*motorL.setSpeed(800);
                motorR.setSpeed(800);
                delay(1000);
                motorL.brake();
                motorR.brake();*/
                shootSequence(false, 90);
                shootSequence(false, 60);
                shootSequence(false, 110);
            }

            if(checkpointCounter == servoCheckpoint){
                shootSequence(false, 150);
            }
            break;
        default:
            break;
        }
        oldLineStatus = lineStatus;
    }
}
