LarsN05/InnovationsProjekt/(commit log)

2026-09-24 code hinzugefügt
    [A01_Batterie-Halterung.stp, A04_Abstandshalter.stp, A05_Grundplatte.stp, A06_Drehrollen-Halterung.stp, A09_Sensor-Rahmen.stp, A10_Sensor-Stütze.stp, A11_Motorshield-Stütze.stp, A12_Motorshield-Rahmen.stp]
2026-09-28 turn and stop case in line-follower.cpp
    added checkpointconstants finalCheckpoint and turnCheckpoint
    added cases for turning and stopping in line-follower.cpp
2026-09-28 perform180Turn failsafe
    added a failsafe to perform180turn to make sure it doesn't stop early on a perpendicular line
    made the turnright/turnleft functions public to all files that include "qtr-sensor-util.h"
    [config.h, line-follower.cpp, movement-functions.cpp, qtr-sensor-util.h]
2026-09-28 changes after testing session 1
    added dc and servo motor
2026-10-28 Benchmark2 funktionalität hinzugefügt
    kalibrierung verbessert
    encoder motor funktionalität hinzugefügt
    encoder webinterface hinzugefügt
    verschiedene serial monitor werte hinzugefügt
    sequenz bei ladestation hinzugefügt
